brenulevi/airplane/Hardware/3D_Models/IND_PA4343_FOOTPRINT2_PUL.step

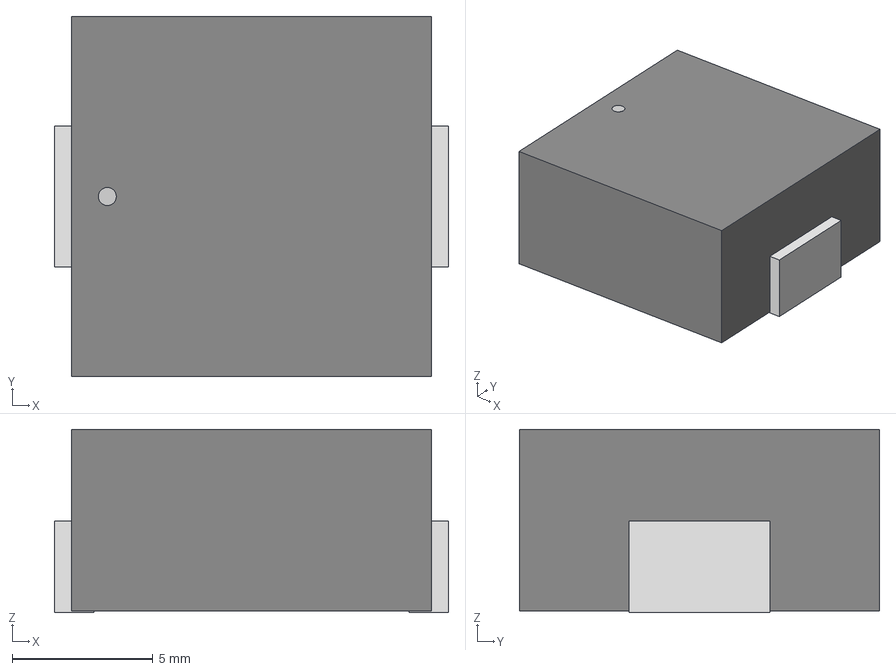
[picture p2: CAD file, 2026-01-26]
Hardware/3D_Models/IND_PA4343_FOOTPRINT2_PUL.step
14.0 x 12.8 x 6.50 mm
