brenulevi/airplane/Hardware/3D_Models/W25N01GVZEIG.STEP

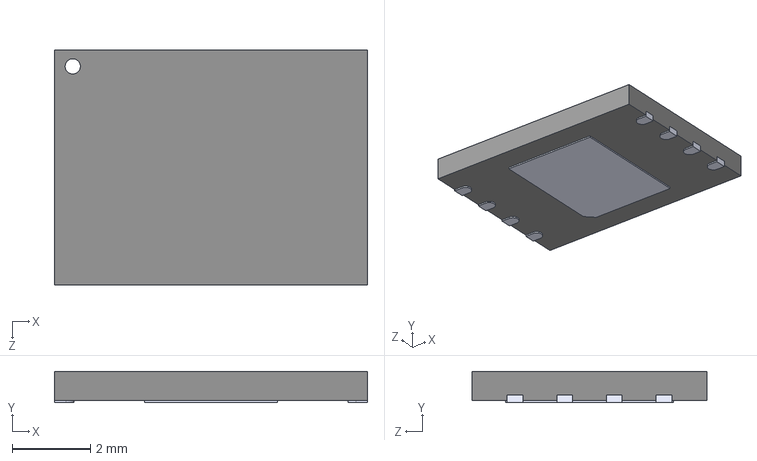
[picture p4: CAD file, 2026-01-26]
Hardware/3D_Models/W25N01GVZEIG.STEP
8.00 x 0.8 x 6.00 mm
