brenulevi/airplane/3D_Models/10LGA_2X2X0p75_BOS.step

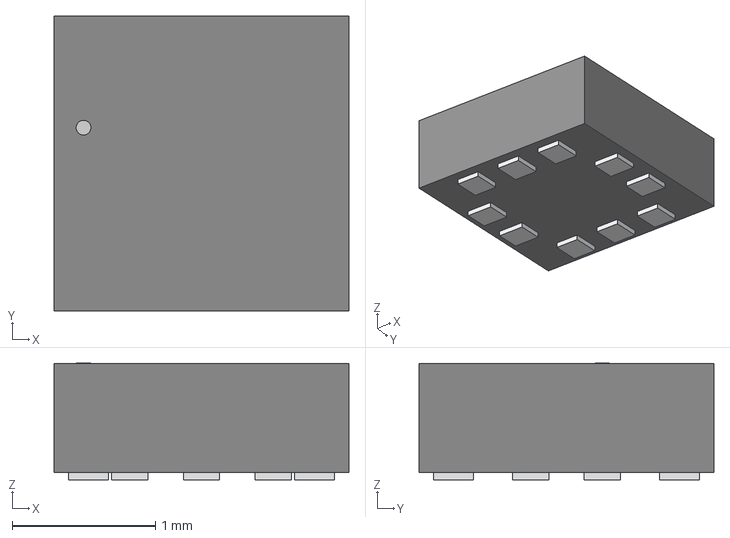
[picture p5: CAD file, 2026-01-13]
3D_Models/10LGA_2X2X0p75_BOS.step
2.06 x 2.06 x 0.815 mm
