brenulevi/airplane/3D_Models/BMI088.step

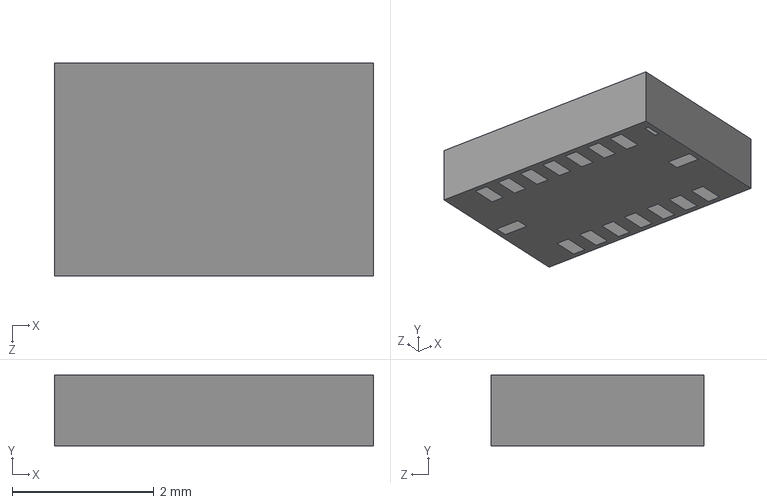
[picture p6: CAD file, 2026-01-13]
3D_Models/BMI088.step
4.50 x 1.00 x 3.00 mm
