brenulevi/airplane/Hardware/3D_Models/DM3AT-SF-PEJM5.step

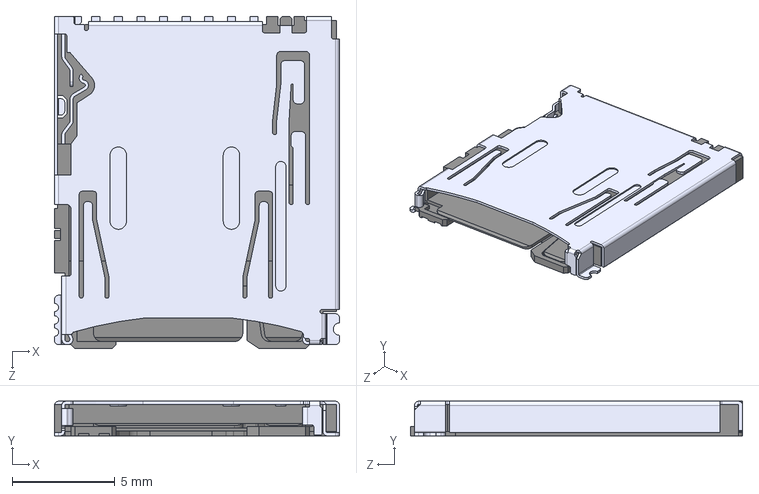
[picture p7: CAD file, 2026-01-26]
Hardware/3D_Models/DM3AT-SF-PEJM5.step
13.8 x 1.68 x 16.2 mm
