brenulevi/airplane/3D_Models/SON_DFN6_3X3_STM.step

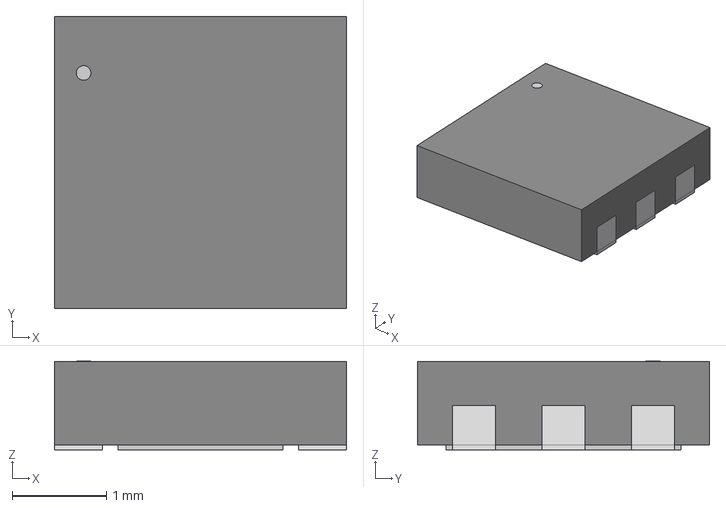
[picture p8: CAD file, 2026-01-13]
3D_Models/SON_DFN6_3X3_STM.step
3.10 x 3.10 x 0.942 mm
