brenulevi/airplane/Hardware/3D_Models/U.FL-R-SMT-1.stp

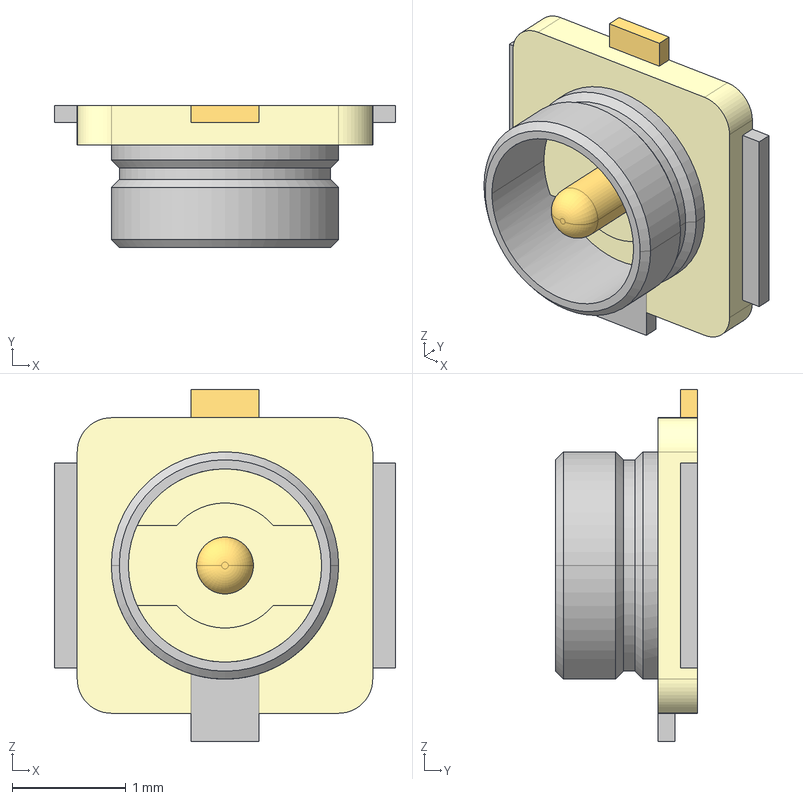
[picture p9: CAD file, 2026-01-23]
Hardware/3D_Models/U.FL-R-SMT-1.stp
3.00 x 1.25 x 3.10 mm
