brenulevi/airplane/3D_Models/IST8310.step

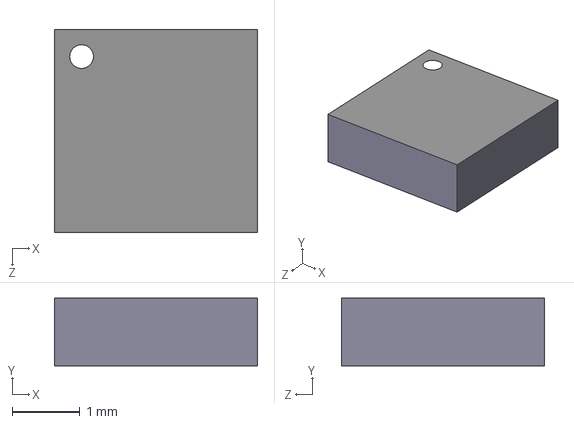
[picture p10: CAD file, 2026-01-13]
3D_Models/IST8310.step
3.00 x 1.00 x 3.00 mm
