brenulevi/airplane/Hardware/3D_Models/skrpace010.stp

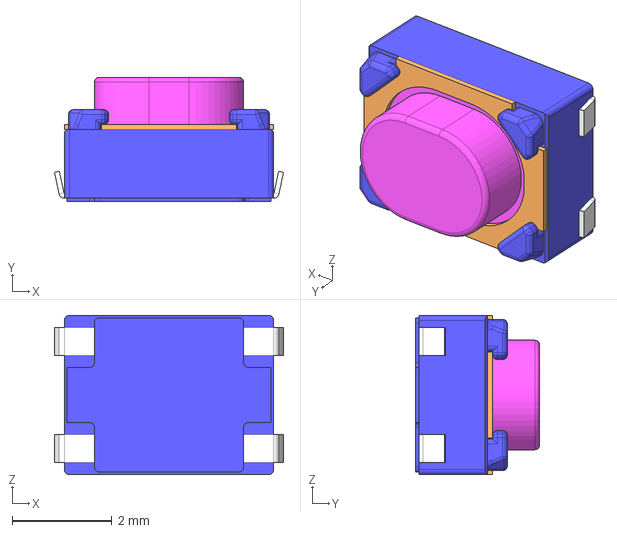
[picture p11: CAD file, 2026-01-23]
Hardware/3D_Models/skrpace010.stp
4.60 x 2.50 x 3.20 mm
