brenulevi/airplane/Hardware/3D_Models/B10B-PHDSS.STEP

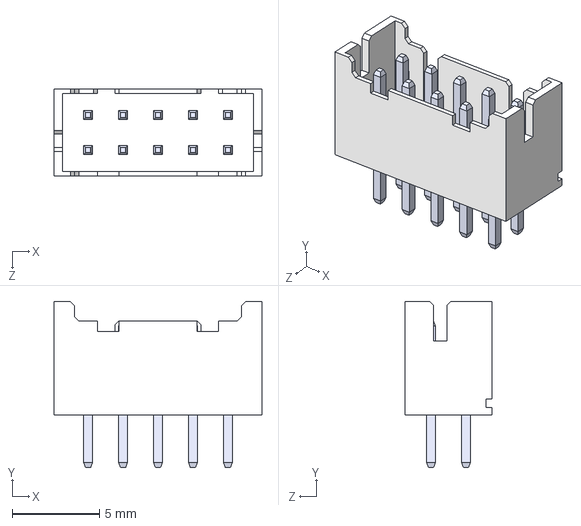
[picture p13: CAD file, 2026-01-23]
Hardware/3D_Models/B10B-PHDSS.STEP
11.9 x 9.50 x 5.00 mm
BxB-PHDSS_10
pin^BxB-PHDSS ass x 10
