brenulevi/airplane/3D_Models/SOT-23-5_2P9X1P6_MCH.step

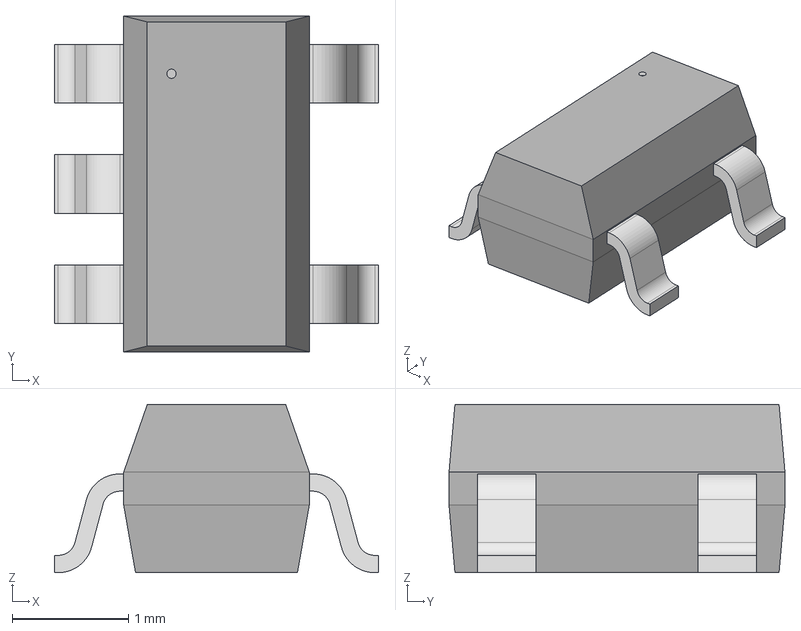
[picture p14: CAD file, 2026-01-13]
3D_Models/SOT-23-5_2P9X1P6_MCH.step
2.79 x 2.90 x 1.45 mm
