brenulevi/airplane/3D_Models/MIC26903YJL-TR.step

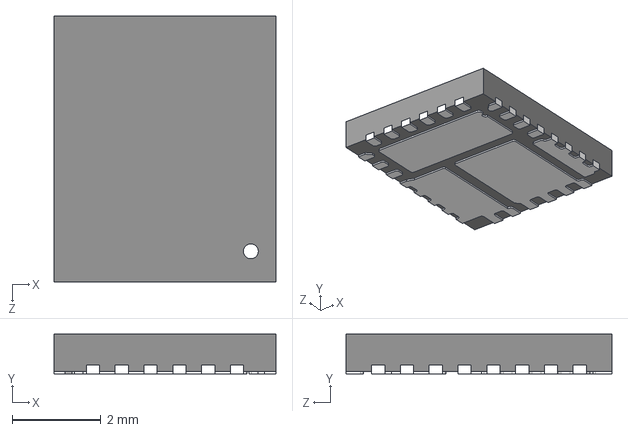
[picture p15: CAD file, 2026-01-13]
3D_Models/MIC26903YJL-TR.step
5.00 x 0.9 x 6.00 mm
