brenulevi/airplane/(list of files, cad)

Other CAD files:
Hardware/3D_Models/PTS815SJM250SMTRLFS.stp
Hardware/3D_Models/W25N01GVZEIG TR.STEP
