brenulevi/airplane/Hardware/aircraft.kicad_pcb

## KiCad design Hardware/aircraft.kicad_pcb (2026-01-28)

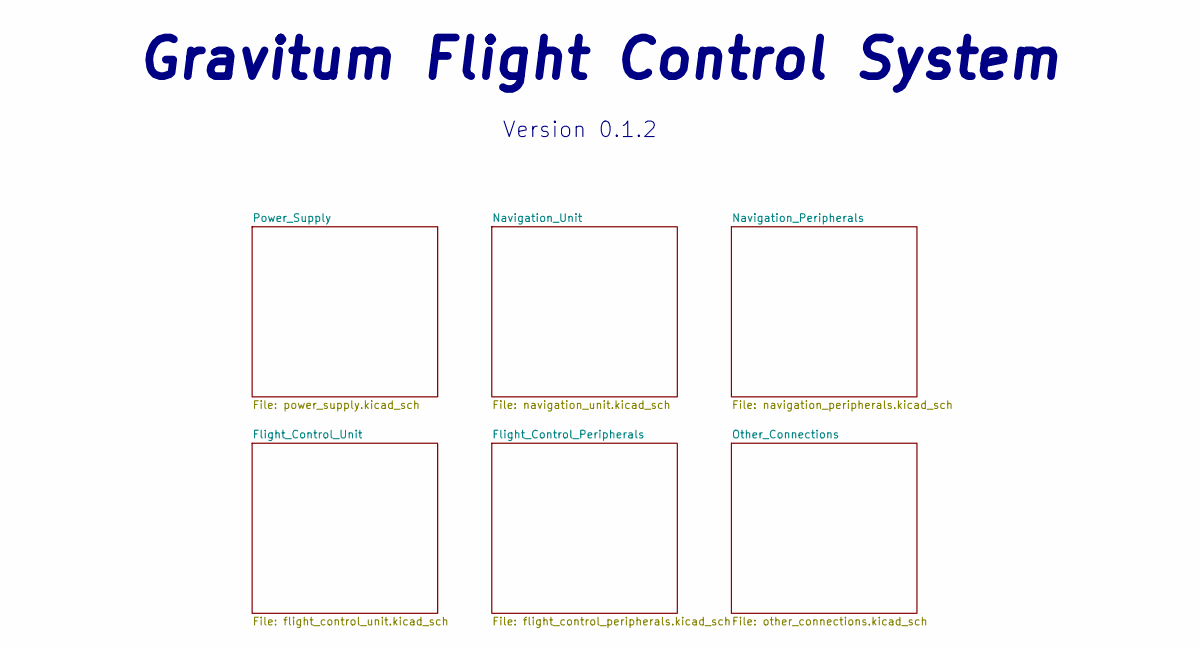
[picture p23: schematic aircraft.kicad_sch, Gravitum Flight Control System]

Notes on the sheet:
Gravitum Flight Control System
Version 0.1.2

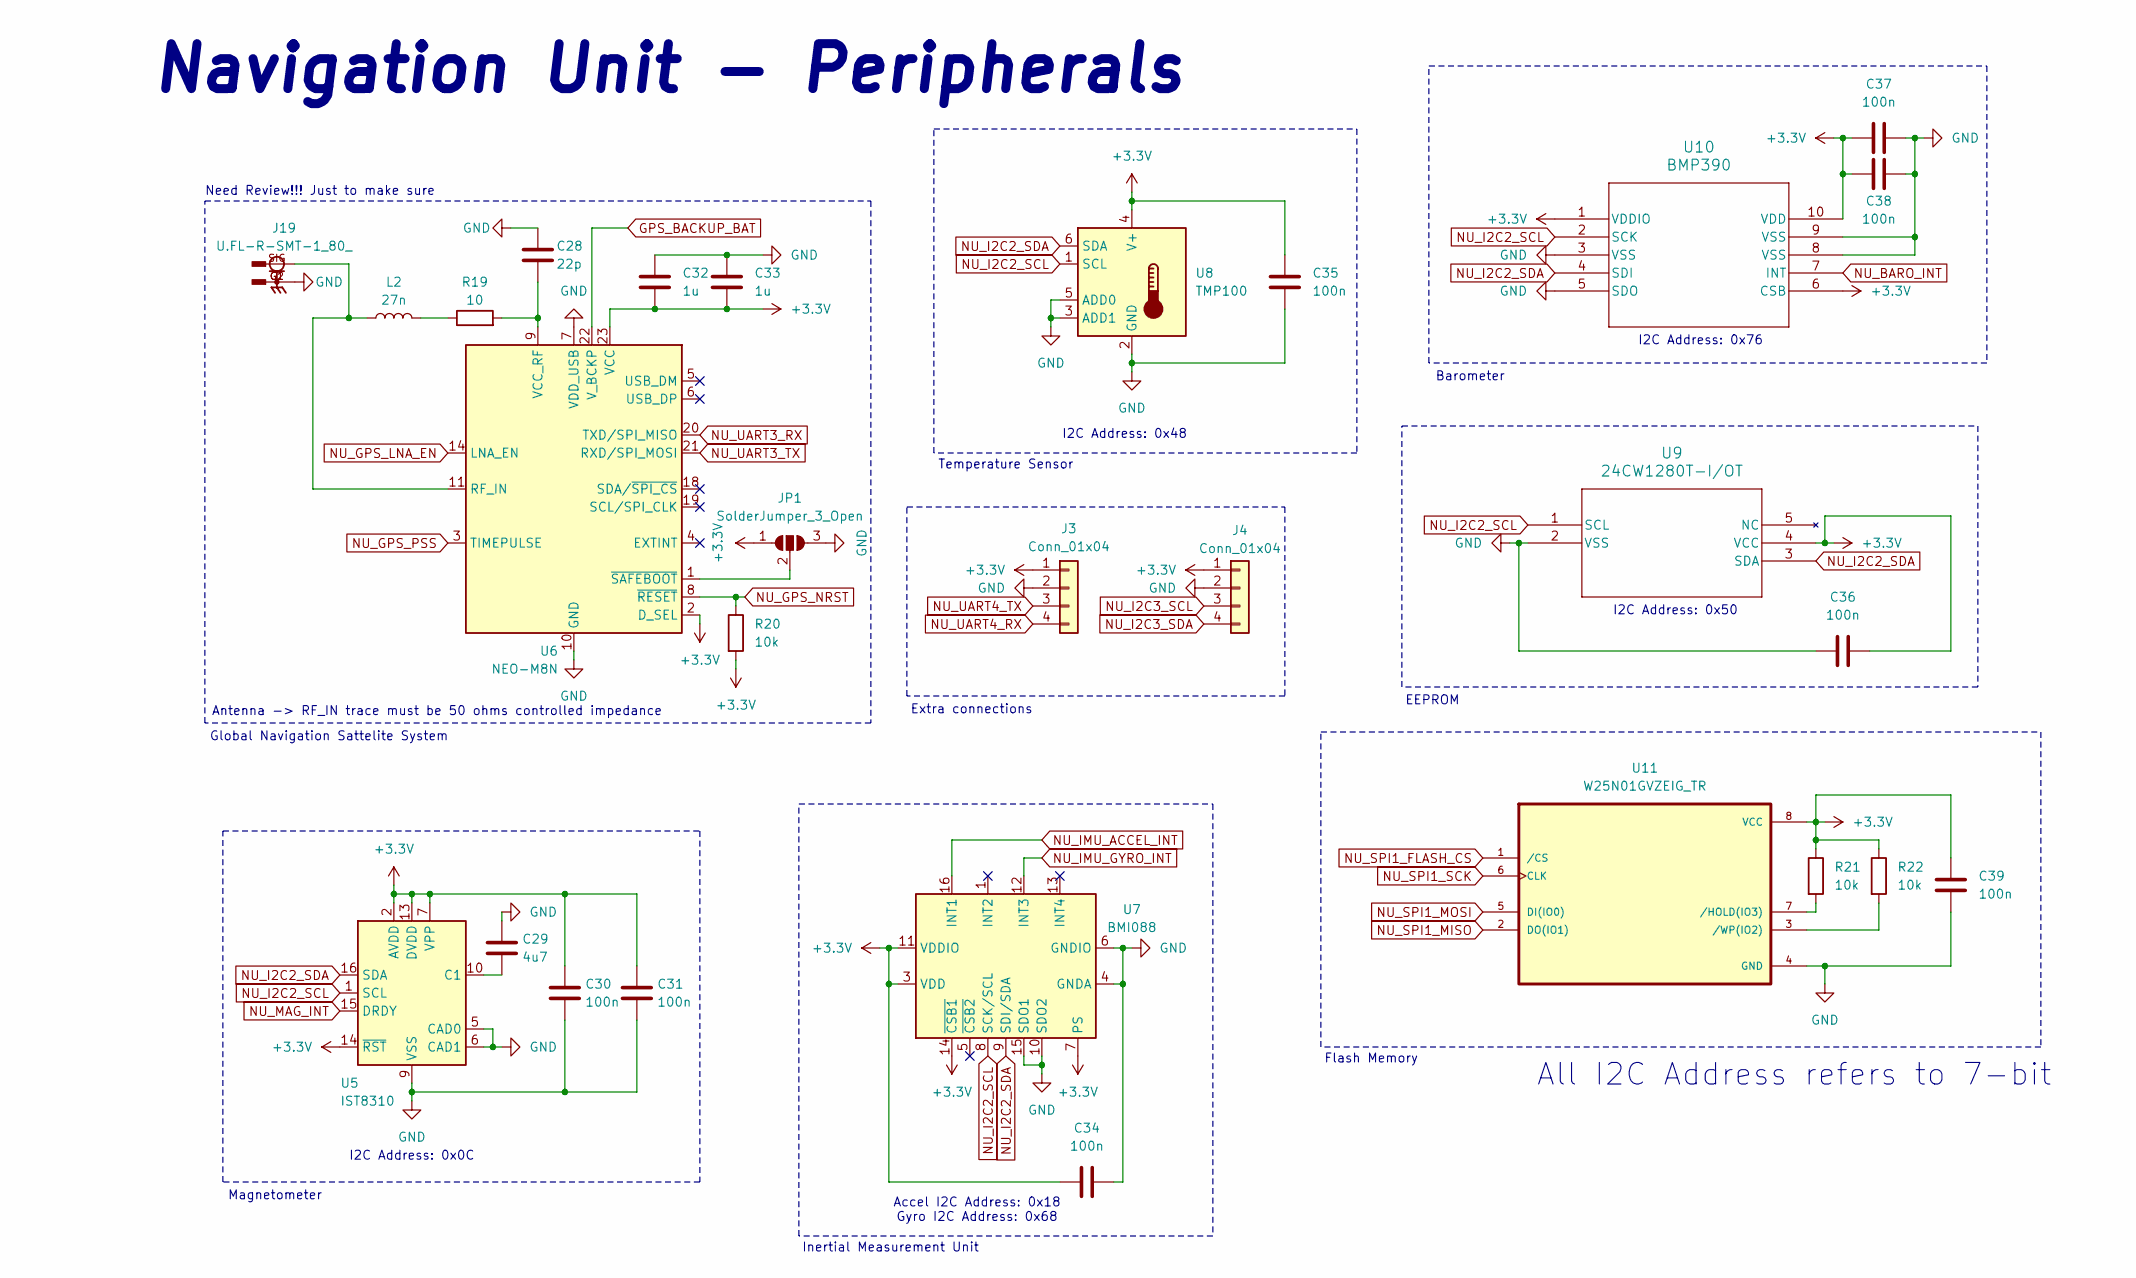
[picture p24: schematic navigation_peripherals.kicad_sch, Navigation Unit - Peripherals]

Parts:
C28: 22p; C_0603_1608Metric; MPN C0603C220J8GACTU
C29: 4u7; C_0805_2012Metric_Pad1.18x1.45mm_HandSolder; MPN CL21B475KPFNNNE
C30, C31, C34, C35, C36, C37, C38, C39: 100n; C_0603_1608Metric; MPN C0603C104K8RACTU
C32, C33: 1u; C_0603_1608Metric_Pad1.08x0.95mm_HandSolder; MPN CL10B105KP8NNNC
J3, J4: Conn_01x04; JST_PH_S4B-PH-K_1x04_P2.00mm_Horizontal; MPN S4B-PH-K-S
J19: U.FL-R-SMT-1_80_; HIROSE_U.FL-R-SMT-1_80_; PARTREV Jul.1.2022
JP1: SolderJumper_3_Open; SolderJumper-3_P1.3mm_Open_RoundedPad1.0x1.5mm_NumberLabels
L2: 27n; L_0603_1608Metric_Pad1.05x0.95mm_HandSolder; MPN B82496C3270J000
R19: 10; R_0603_1608Metric_Pad0.98x0.95mm_HandSolder; MPN RMCF0603FT10R0
R20, R21, R22: 10k; R_0603_1608Metric_Pad0.98x0.95mm_HandSolder; MPN RC0603FR-0710KL
U5: IST8310; LGA-16_3x3mm_P0.5mm; MPN IST8310
U6: NEO-M8N; XCVR_NEO-M8N-0; MPN NEO-M8N-0
U7: BMI088; Bosch_LGA-16_4.5x3mm_P0.5mm_LayoutBorder7x1y_ClockwisePinNu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; MPN BMI088
U8: TMP100; SOT-23-6; MPN TMP100NA-3K
U9: 24CW1280T-I/OT; SOT-23-5_2P9X1P6_MCH; MPN 24CW1280T-I/OT
U10: BMP390; 10LGA_2X2X0p75_BOS; MPN BMP390
U11: W25N01GVZEIG_TR; SON127P800X600X80-9N; MPN W25N01GVZEIG-TR

Connections:
+3.3V: C30.1, C31.1, C32.2, C33.2, C34.1, C35.2, C36.1, C37.2, C38.2, C39.1, J3.1, J4.1, JP1.1 (A), R20.2, R21.1, R22.1, U5.2 (AVDD), U5.7 (VPP), U5.13 (DVDD), U5.14 (~RST), U6.2 (D_SEL), U6.23 (VCC), U7.3 (VDD), U7.7 (PS), U7.11 (VDDIO), U7.14 (~CSB1), U8.4 (V+), U9.4 (VCC), U10.1 (VDDIO), U10.6 (CSB), U10.10 (VDD), U11.8 (VCC); also elsewhere on the board
GND: C28.1, C29.1, C30.2, C31.2, C32.1, C33.1, C34.2, C35.1, C36.2, C37.1, C38.1, C39.2, J3.2, J4.2, J19.G1, J19.G2, JP1.3 (B), U5.5 (CAD0), U5.6 (CAD1), U5.9 (VSS), U5.11 (VSS), U6.7 (VDD_USB), U6.10 (GND), U6.12 (GND), U6.13 (GND), U6.24 (GND), U7.2 (GNDA), U7.4 (GNDA), U7.6 (GNDIO), U7.10 (SDO2), U7.15 (SDO1), U8.2 (GND), U8.3 (ADD1), U8.5 (ADD0), U9.2 (VSS), U10.3 (VSS), U10.5 (SDO), U10.8 (VSS), U10.9 (VSS), U11.4 (GND); also elsewhere on the board
GPS_BACKUP_BAT: U6.22 (V_BCKP); also elsewhere on the board
NU_BARO_INT: U10.7 (INT); also elsewhere on the board
NU_GPS_LNA_EN: U6.14 (LNA_EN); also elsewhere on the board
NU_GPS_NRST: R20.1, U6.8 (~RESET); also elsewhere on the board
NU_GPS_PSS: U6.3 (TIMEPULSE); also elsewhere on the board
NU_I2C2_SCL: U5.1 (SCL), U7.8 (SCK/SCL), U8.1 (SCL), U9.1 (SCL), U10.2 (SCK); also elsewhere on the board
NU_I2C2_SDA: U5.16 (SDA), U7.9 (SDI/SDA), U8.6 (SDA), U9.3 (SDA), U10.4 (SDI); also elsewhere on the board
NU_I2C3_SCL: J4.3; also elsewhere on the board
NU_I2C3_SDA: J4.4; also elsewhere on the board
NU_IMU_ACCEL_INT: U7.16 (INT1); also elsewhere on the board
NU_IMU_GYRO_INT: U7.12 (INT3); also elsewhere on the board
NU_MAG_INT: U5.15 (DRDY); also elsewhere on the board
NU_SPI1_FLASH_CS: U11.1 (/CS); also elsewhere on the board
NU_SPI1_MISO: U11.2 (DO(IO1)); also elsewhere on the board
NU_SPI1_MOSI: U11.5 (DI(IO0)); also elsewhere on the board
NU_SPI1_SCK: U11.6 (CLK); also elsewhere on the board
NU_UART3_RX: U6.20 (TXD/SPI_MISO); also elsewhere on the board
NU_UART3_TX: U6.21 (RXD/SPI_MOSI); also elsewhere on the board
NU_UART4_RX: J3.4; also elsewhere on the board
NU_UART4_TX: J3.3; also elsewhere on the board
unnamed: JP1.2 (C), U6.1 (~SAFEBOOT)
unnamed: L2.2, R19.1
unnamed: C29.2, U5.10 (C1)
unnamed: J19.SIG, L2.1, U6.11 (RF_IN)
unnamed: C28.2, R19.2, U6.9 (VCC_RF)
unnamed: R21.2, U11.7 (/HOLD(IO3))
unnamed: R22.2, U11.3 (/WP(IO2))

Notes on the sheet:
Magnetometer
Navigation Unit - Peripherals
I2C Address: 0x48
Flash Memory
I2C Address: 0x76
Barometer
Temperature Sensor
Accel I2C Address: 0x18 Gyro I2C Address: 0x68
EEPROM
Need Review!!! Just to make sure
Global Navigation Sattelite System
Inertial Measurement Unit
All I2C Address refers to 7-bit
Antenna -> RF_IN trace must be 50 ohms controlled impedance
I2C Address: 0x0C
I2C Address: 0x50
Extra connections

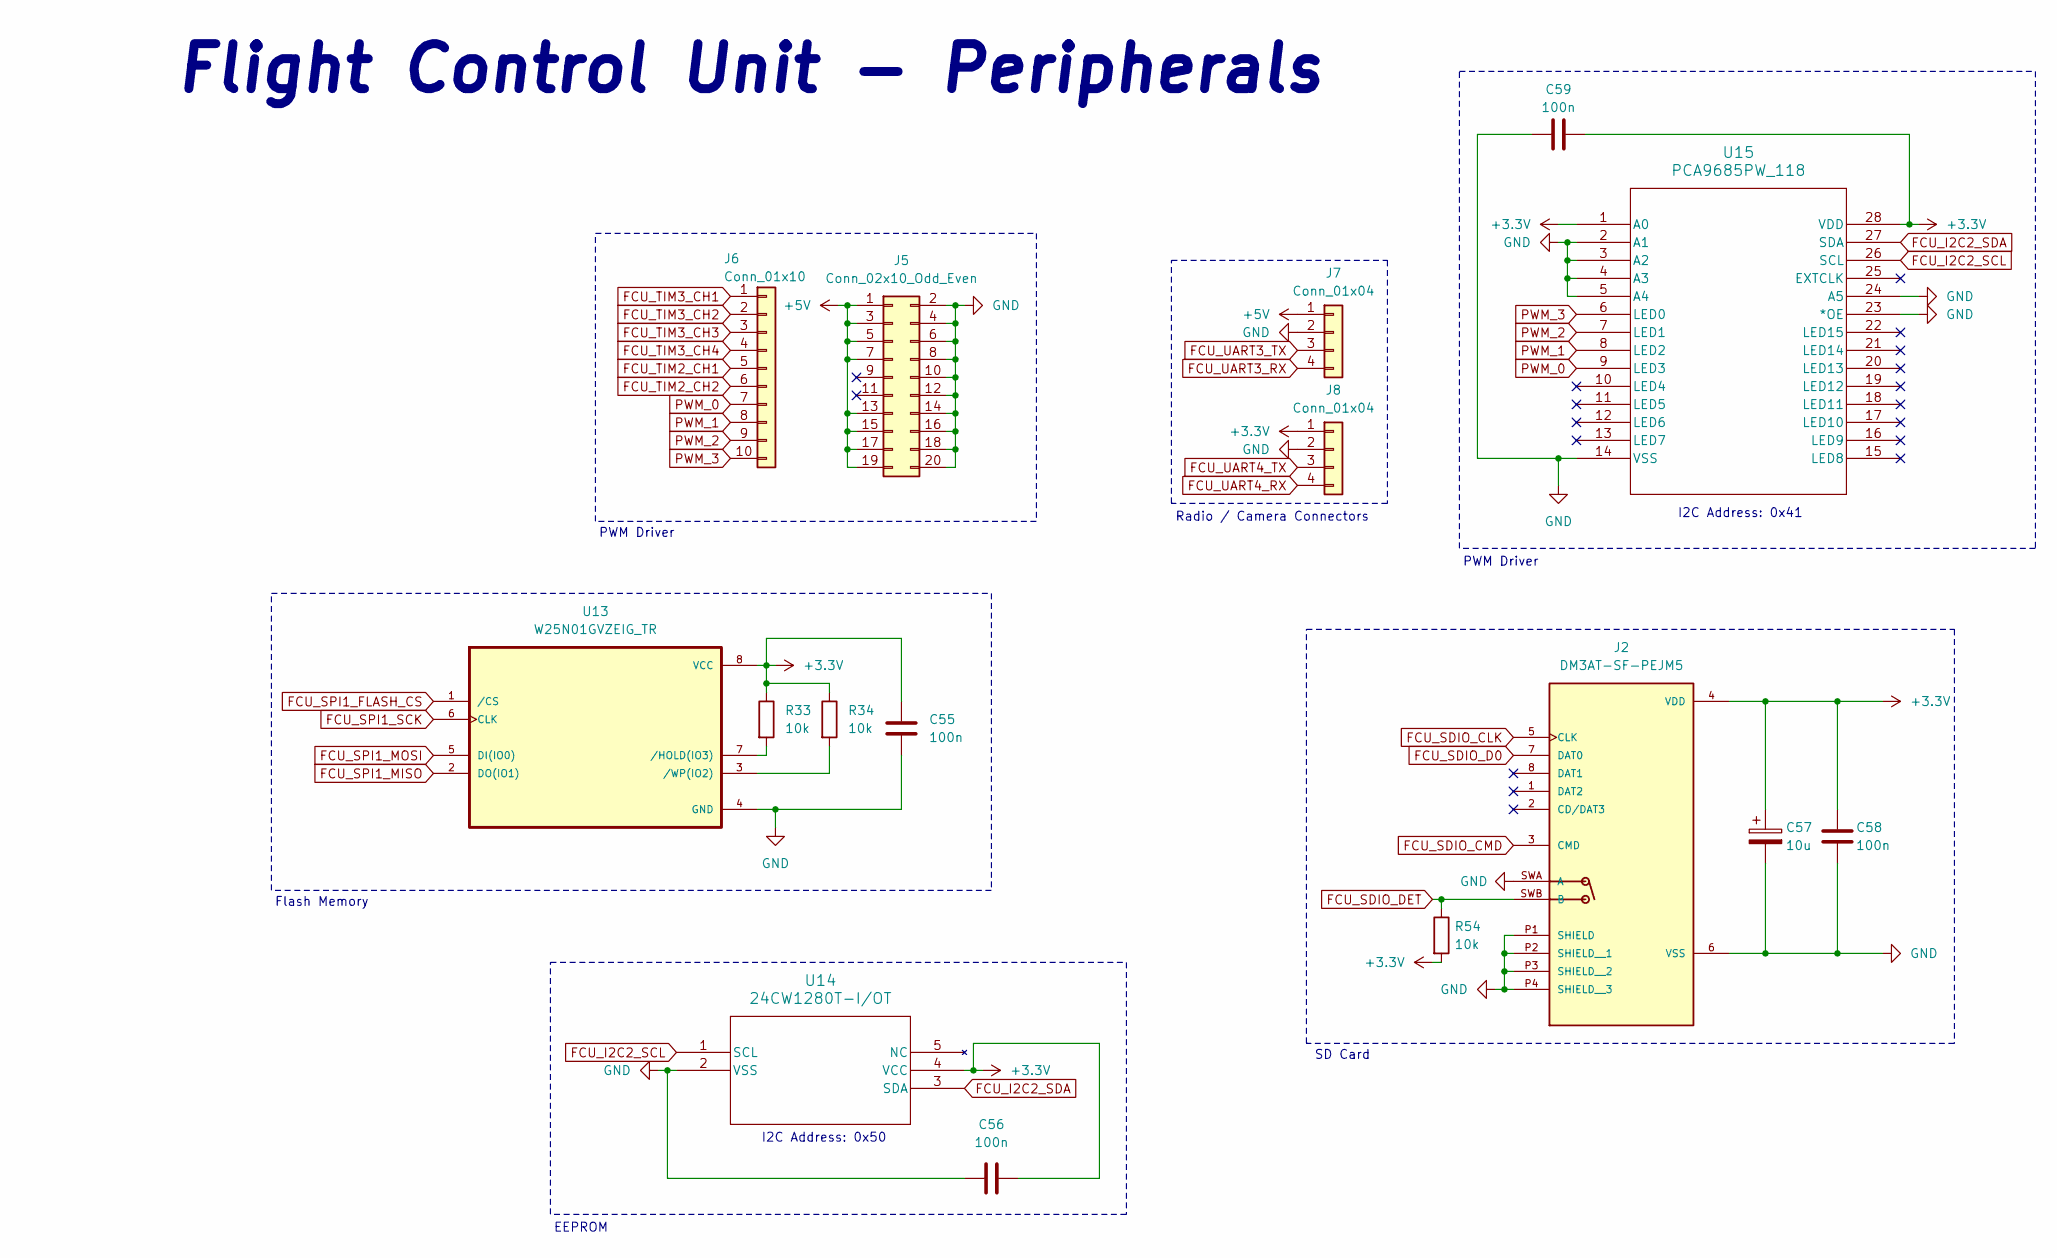
[picture p25: schematic flight_control_peripherals.kicad_sch, Flight Control Unit - Peripherals]

Parts:
C55, C56, C58, C59: 100n; C_0402_1005Metric; MPN C0603C104K8RACTU
C57: 10u; C_0603_1608Metric; MPN TAJA106K010TNJ
J2: DM3AT-SF-PEJM5; HRS_DM3AT-SF-PEJM5; PARTREV 20200913
J5: Conn_02x10_Odd_Even; PinHeader_2x10_P2.54mm_Vertical
J6: Conn_01x10; PinHeader_1x10_P2.54mm_Vertical
J7, J8: Conn_01x04; JST_PH_S4B-PH-K_1x04_P2.00mm_Horizontal; MPN S4B-PH-K-S
R33, R34, R54: 10k; R_0402_1005Metric; MPN RC0603FR-0710KL
U13: W25N01GVZEIG_TR; SON127P800X600X80-9N; MPN W25N01GVZEIG-TR
U14: 24CW1280T-I/OT; SOT-23-5_2P9X1P6_MCH; MPN 24CW1280T-I/OT
U15: PCA9685PW_118; TSSOP28_SOT361-1_NXP; MPN PCA9685PW,118

Connections:
+3.3V: C55.1, C56.1, C57.1, C58.1, C59.1, J2.4 (VDD), J8.1, R33.1, R34.1, R54.2, U13.8 (VCC), U14.4 (VCC), U15.1 (A0), U15.28 (VDD); also elsewhere on the board
+5V: J5.1, J5.3, J5.5, J5.7, J5.13, J5.15, J5.17, J5.19, J7.1; also elsewhere on the board
FCU_I2C2_SCL: U14.1 (SCL), U15.26 (SCL); also elsewhere on the board
FCU_I2C2_SDA: U14.3 (SDA), U15.27 (SDA); also elsewhere on the board
FCU_SDIO_CLK: J2.5 (CLK); also elsewhere on the board
FCU_SDIO_CMD: J2.3 (CMD); also elsewhere on the board
FCU_SDIO_D0: J2.7 (DAT0); also elsewhere on the board
FCU_SDIO_DET: J2.SWB (B), R54.1; also elsewhere on the board
FCU_SPI1_FLASH_CS: U13.1 (/CS); also elsewhere on the board
FCU_SPI1_MISO: U13.2 (DO(IO1)); also elsewhere on the board
FCU_SPI1_MOSI: U13.5 (DI(IO0)); also elsewhere on the board
FCU_SPI1_SCK: U13.6 (CLK); also elsewhere on the board
FCU_TIM2_CH1: J6.5; also elsewhere on the board
FCU_TIM2_CH2: J6.6; also elsewhere on the board
FCU_TIM3_CH1: J6.1; also elsewhere on the board
FCU_TIM3_CH2: J6.2; also elsewhere on the board
FCU_TIM3_CH3: J6.3; also elsewhere on the board
FCU_TIM3_CH4: J6.4; also elsewhere on the board
FCU_UART3_RX: J7.4; also elsewhere on the board
FCU_UART3_TX: J7.3; also elsewhere on the board
FCU_UART4_RX: J8.4; also elsewhere on the board
FCU_UART4_TX: J8.3; also elsewhere on the board
GND: C55.2, C56.2, C57.2, C58.2, C59.2, J2.6 (VSS), J2.P1 (SHIELD), J2.P2 (SHIELD__1), J2.P3 (SHIELD__2), J2.P4 (SHIELD__3), J2.SWA (A), J5.2, J5.4, J5.6, J5.8, J5.10, J5.12, J5.14, J5.16, J5.18, J5.20, J7.2, J8.2, U13.4 (GND), U14.2 (VSS), U15.2 (A1), U15.3 (A2), U15.4 (A3), U15.5 (A4), U15.14 (VSS), U15.23 (*OE), U15.24 (A5); also elsewhere on the board
unnamed: R33.2, U13.7 (/HOLD(IO3))
unnamed: R34.2, U13.3 (/WP(IO2))
PWM_0: J6.7, U15.9 (LED3)
PWM_1: J6.8, U15.8 (LED2)
PWM_2: J6.9, U15.7 (LED1)
PWM_3: J6.10, U15.6 (LED0)

Notes on the sheet:
I2C Address: 0x50
I2C Address: 0x41
Radio / Camera Connectors
SD Card
PWM Driver
Flash Memory
Flight Control Unit - Peripherals
EEPROM

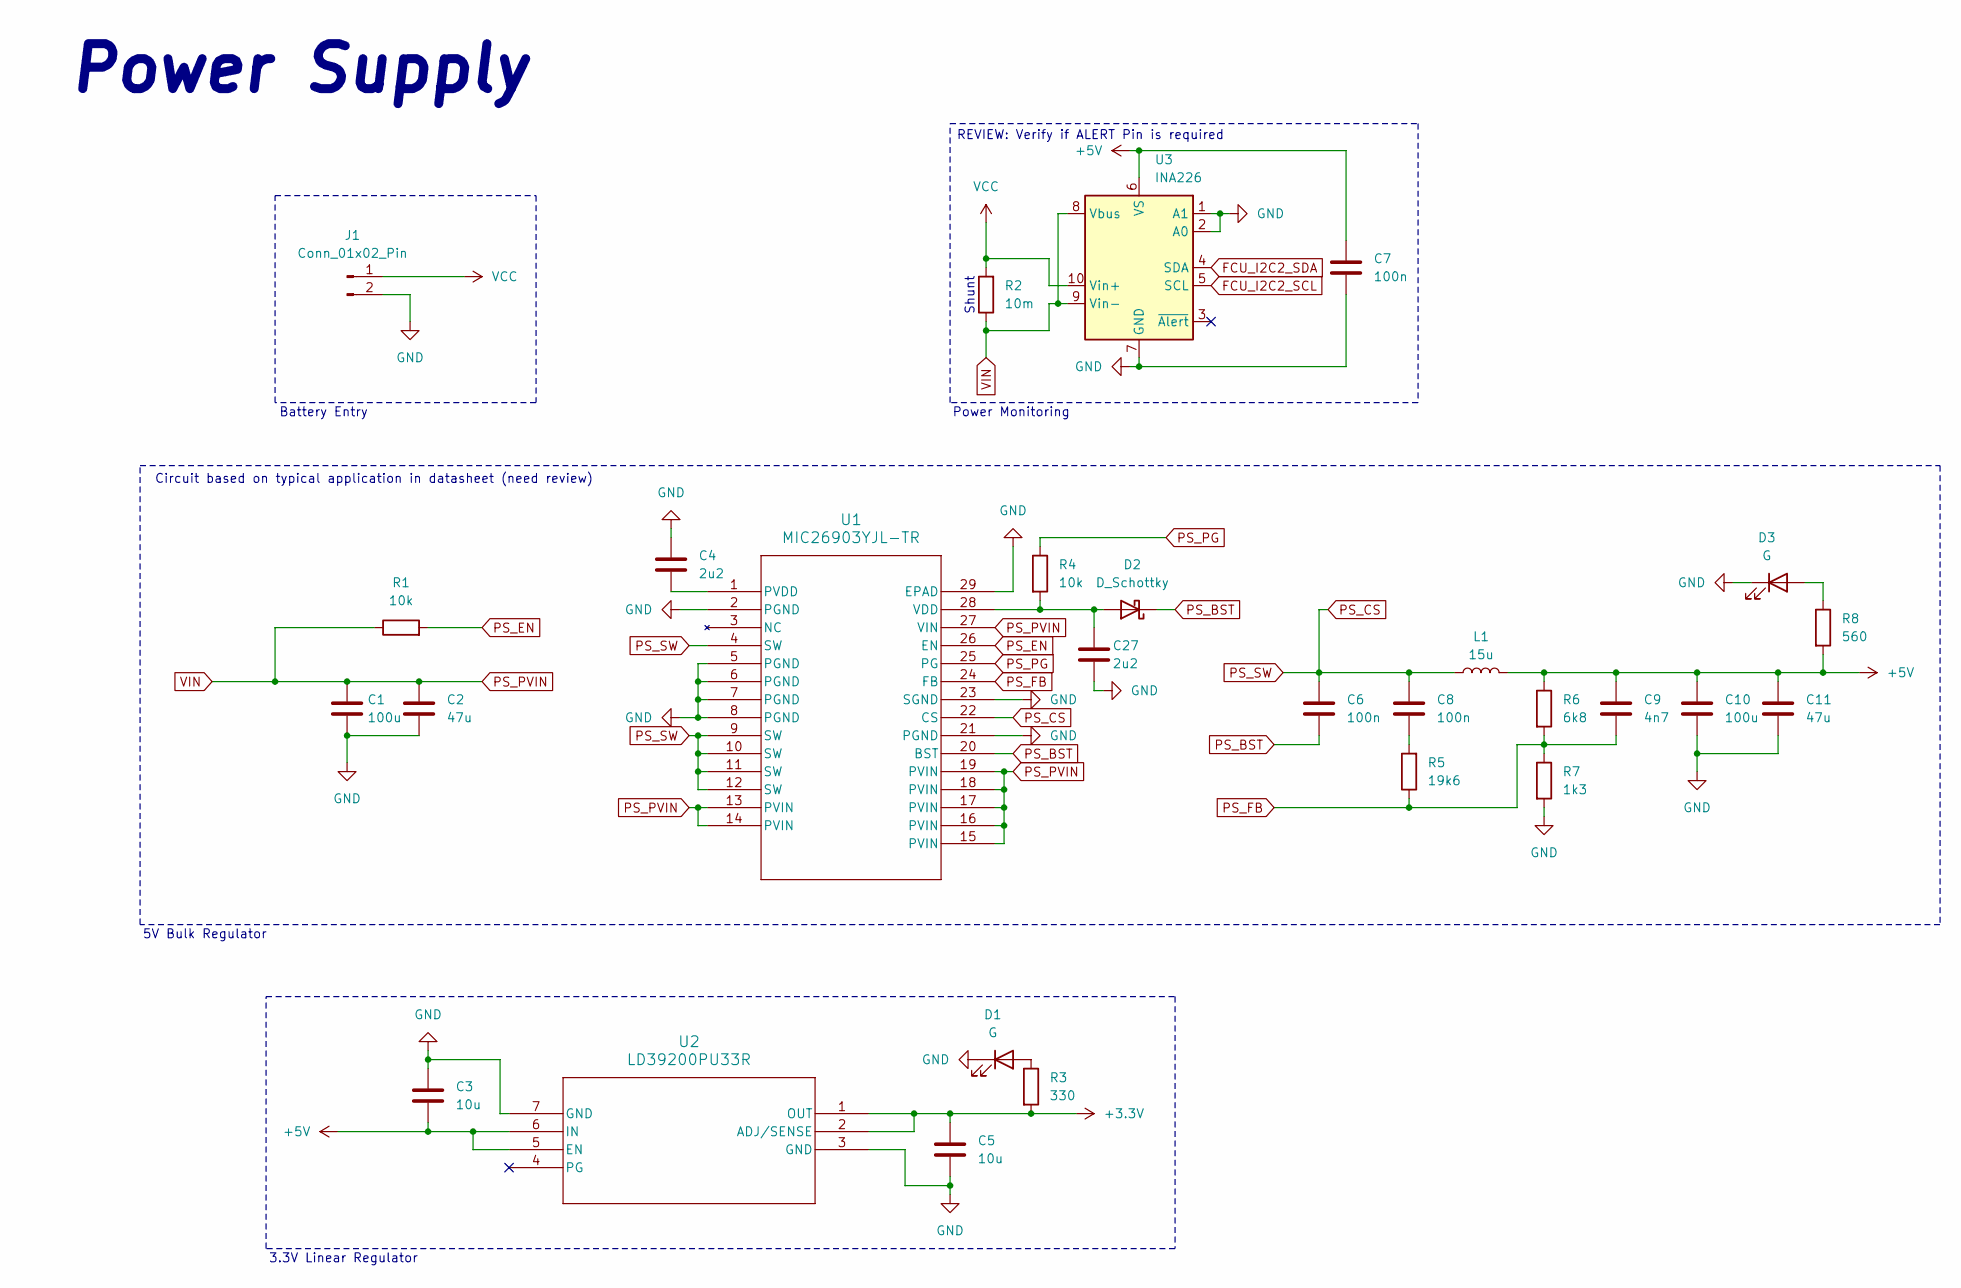
[picture p26: schematic power_supply.kicad_sch, Power Supply]

Parts:
C1, C10: 100u; C_Elec_6.3x7.7; MPN A768EB107M1ELAS036
C2, C11: 47u; C_1206_3216Metric_Pad1.33x1.80mm_HandSolder; MPN C3216X5R1E476M160AC
C3, C5: 10u; C_0805_2012Metric_Pad1.18x1.45mm_HandSolder; MPN CL21B106KPQNNNE
C4, C27: 2u2; C_0805_2012Metric_Pad1.18x1.45mm_HandSolder; MPN 08053C225KAT2A
C6, C7, C8: 100n; C_0603_1608Metric_Pad1.08x0.95mm_HandSolder; MPN C0603C104K3RACTU
C9: 4n7; C_0603_1608Metric_Pad1.08x0.95mm_HandSolder; MPN C0603C472F3GACTU
D1, D3: G; LED_0603_1608Metric_Pad1.05x0.95mm_HandSolder; MPN LTST-S270KGKT
D2: D_Schottky; D_SOD-323_HandSoldering; MPN SD103AWS
J1: Conn_01x02_Pin; AMASS_XT60-M_1x02_P7.20mm_Vertical; MPN 11864
L1: 15u; IND_PA4343_FOOTPRINT2_PUL; MPN PA4343-103ANLT
R1, R4: 10k; R_0603_1608Metric_Pad0.98x0.95mm_HandSolder; MPN RC0603FR-0710KL
R2: 10m; R_2512_6332Metric_Pad1.40x3.35mm_HandSolder; MPN CRF2512-FZ-R010ELF
R3: 330; R_0603_1608Metric_Pad0.98x0.95mm_HandSolder; MPN RC0603JR-07330RL
R5: 19k6; R_0603_1608Metric_Pad0.98x0.95mm_HandSolder; MPN CRCW060319K6FKEAC
R6: 6k8; R_0603_1608Metric_Pad0.98x0.95mm_HandSolder; MPN RC0603JR-076K8L
R7: 1k3; R_0603_1608Metric_Pad0.98x0.95mm_HandSolder; MPN RC0603JR-071K3L
R8: 560; R_0603_1608Metric_Pad0.98x0.95mm_HandSolder; MPN RMCF0603FT560R
U1: MIC26903YJL-TR; MLF28_5X6_MCH; MPN MIC26903YJL-TR
U2: LD39200PU33R; SON_DFN6_3X3_STM; MPN LD39200PU33R
U3: INA226; DGS10; MPN INA226AIDGST

Connections:
+3.3V: C5.1, R3.2, U2.1 (OUT), U2.2 (ADJ/SENSE); also elsewhere on the board
+5V: C3.2, C7.1, C9.1, C10.1, C11.1, L1.2, R6.1, R8.2, U2.5 (EN), U2.6 (IN), U3.6 (VS); also elsewhere on the board
FCU_I2C2_SCL: U3.5 (SCL); also elsewhere on the board
FCU_I2C2_SDA: U3.4 (SDA); also elsewhere on the board
GND: C1.2, C2.2, C3.1, C4.1, C5.2, C7.2, C10.2, C11.2, C27.2, D1.1 (K), D3.1 (K), J1.2, R7.2, U1.2 (PGND), U1.5 (PGND), U1.6 (PGND), U1.7 (PGND), U1.8 (PGND), U1.21 (PGND), U1.23 (SGND), U1.29 (EPAD), U2.3 (GND), U2.7 (GND), U3.1 (A1), U3.2 (A0), U3.7 (GND); also elsewhere on the board
unnamed: C8.2, R5.2
unnamed: D1.2 (A), R3.1
unnamed: C27.1, D2.2 (A), R4.2, U1.28 (VDD)
unnamed: D3.2 (A), R8.1
unnamed: C4.2, U1.1 (PVDD)
PS_BST: C6.2, D2.1 (K), U1.20 (BST)
PS_CS: C6.1, C8.1, L1.1, U1.4 (SW), U1.9 (SW), U1.10 (SW), U1.11 (SW), U1.12 (SW), U1.22 (CS)
PS_EN: R1.2, U1.26 (EN)
PS_FB: C9.2, R5.1, R6.2, R7.1, U1.24 (FB)
PS_PG: R4.1, U1.25 (PG)
PS_PVIN: C1.1, C2.1, R1.1, R2.1, U1.13 (PVIN), U1.14 (PVIN), U1.15 (PVIN), U1.16 (PVIN), U1.17 (PVIN), U1.18 (PVIN), U1.19 (PVIN), U1.27 (VIN), U3.8 (Vbus), U3.9 (Vin-); also elsewhere on the board
VIN+: J1.1, R2.2, U3.10 (Vin+); also elsewhere on the board

Notes on the sheet:
Power Supply
Shunt
5V Bulk Regulator
REVIEW: Verify if ALERT Pin is required
Circuit based on typical application in datasheet (need review)
Battery Entry
3.3V Linear Regulator
Power Monitoring

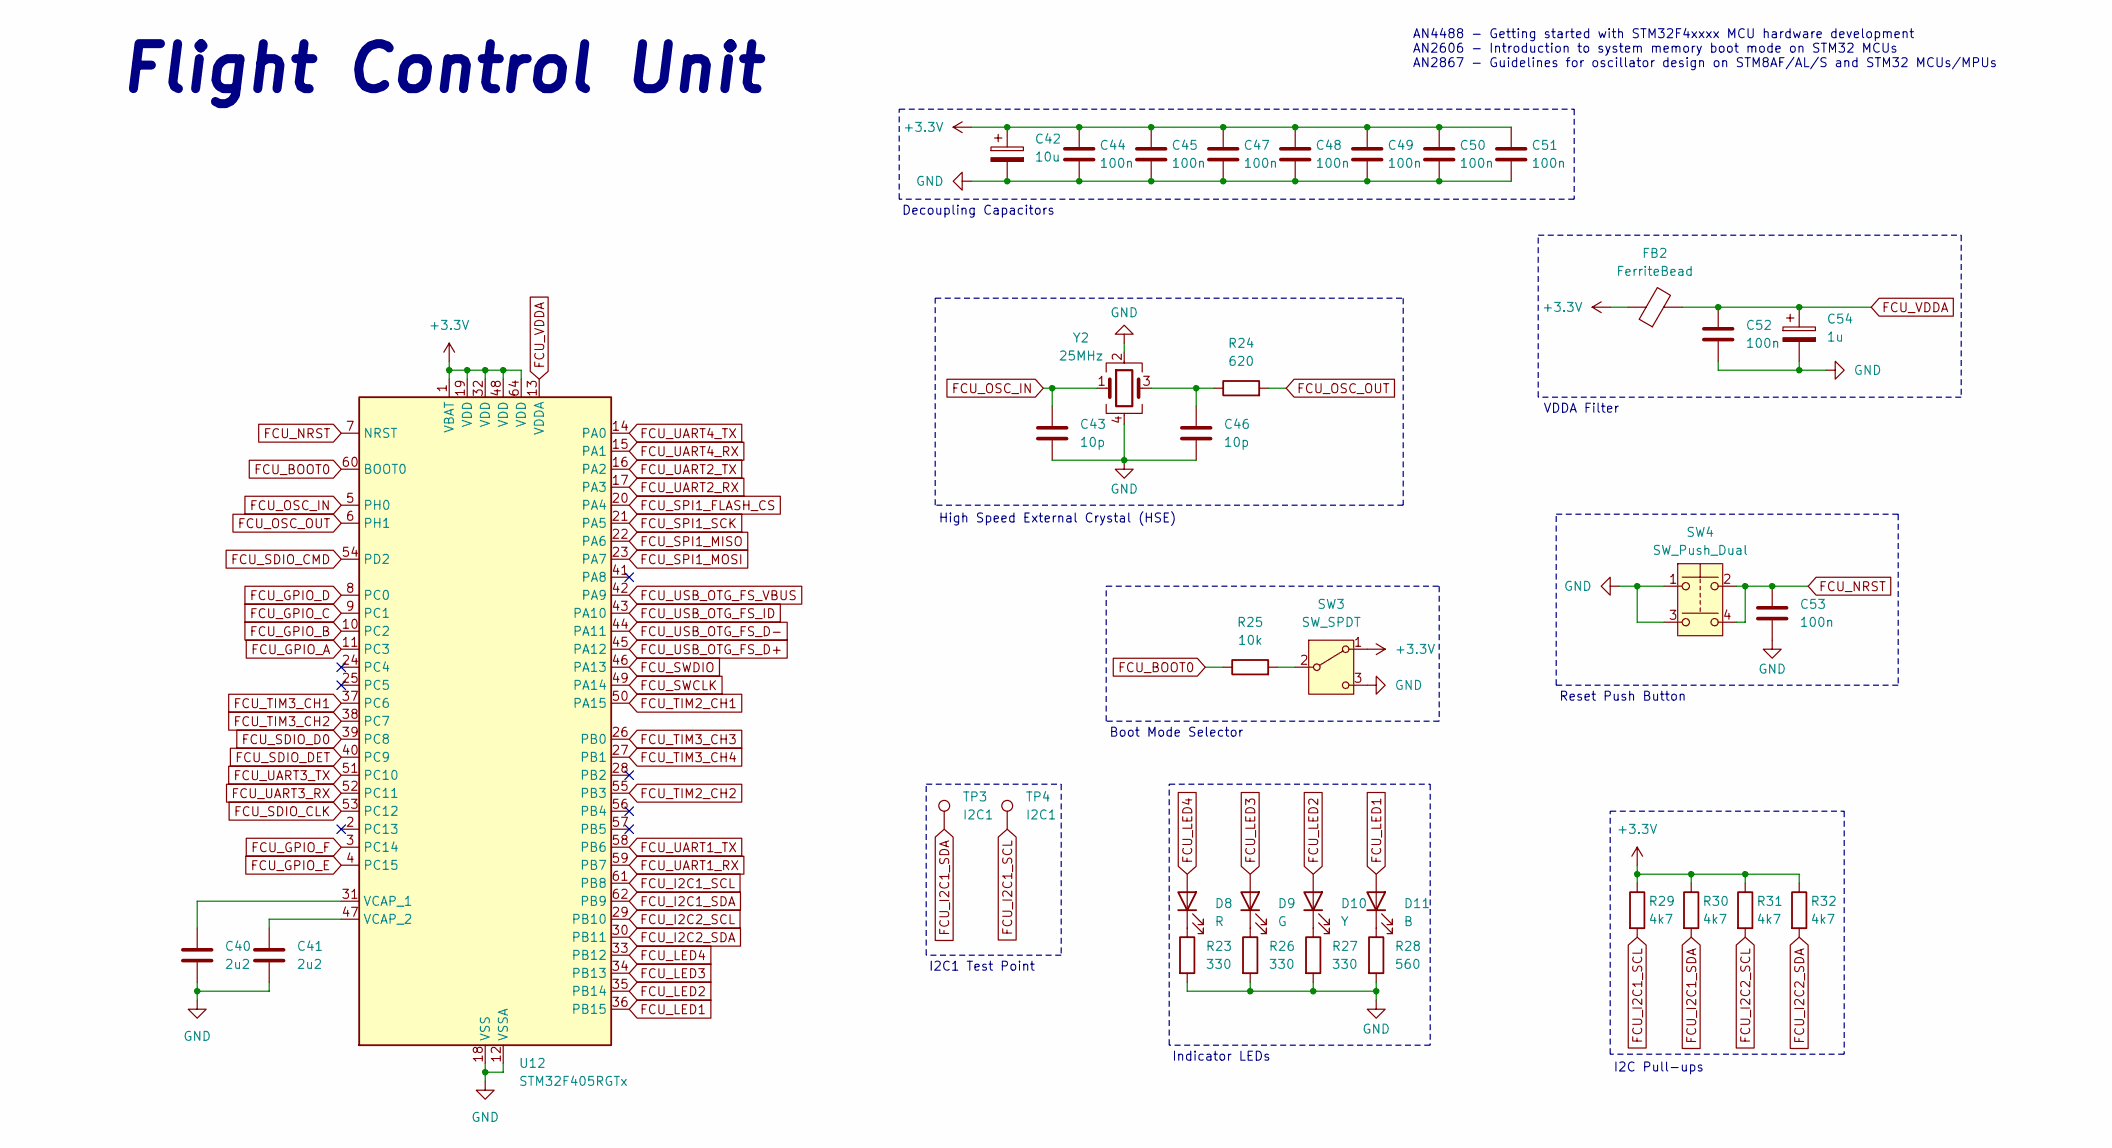
[picture p27: schematic flight_control_unit.kicad_sch, Flight Control Unit]

Parts:
C40, C41: 2u2; C_0402_1005Metric; MPN CL10B225KP8NNNC
C42: 10u; C_0603_1608Metric; MPN TAJA106K010TNJ
C43, C46: 10p; C_0402_1005Metric; MPN 885012005007
C44, C45, C47, C48, C49, C50, C51, C52: 100n; C_0402_1005Metric; MPN CL05B104KP5NNNC
C53: 100n; C_0402_1005Metric; MPN C0603C104K8RACTU
C54: 1u; CP_EIA-1608-08_AVX-J; MPN T491A105K010AT
D8: R; LED_0402_1005Metric; MPN LTST-C171KRKT
D9: G; LED_0402_1005Metric; MPN LTST-C170GKT
D10: Y; LED_0402_1005Metric; MPN LTST-C171YKT
D11: B; LED_0402_1005Metric; MPN LTST-C171TBKT
FB2: FerriteBead; L_0402_1005Metric; MPN HZ0805E601R-10
R23, R26, R27: 330; R_0402_1005Metric; MPN RC0603JR-07330RL
R24: 620; R_0402_1005Metric; MPN RC0603FR-07620RL
R25: 10k; R_0402_1005Metric; MPN RC0603FR-0710KL
R28: 560; R_0402_1005Metric; MPN RMCF0603FT560R
R29, R30, R31, R32: 4k7; R_0402_1005Metric; MPN ERJ-3EKF4701V
SW3: SW_SPDT; SW_SPDT_PCM12; MPN PCM12SMTR
SW4: SW_Push_Dual; SW4_PTS815 SJM 250 SMTR LFS_CNK; MPN PTS815SJM250SMTRLFS
TP3, TP4: I2C1; TestPoint_Pad_D1.0mm
U12: STM32F405RGTx; LQFP-64_10x10mm_P0.5mm; MPN STM32F405RGT6
Y2: 25MHz; Crystal_SMD_Abracon_ABM8G-4Pin_3.2x2.5mm; MPN ABM8G-25.000MHZ-B4Y-T3

Connections:
+3.3V: C42.1, C44.1, C45.1, C47.1, C48.1, C49.1, C50.1, C51.1, FB2.1, R29.1, R30.1, R31.1, R32.1, SW3.1 (A), U12.1 (VBAT), U12.19 (VDD), U12.32 (VDD), U12.48 (VDD), U12.64 (VDD); also elsewhere on the board
FCU_BOOT0: R25.1, U12.60 (BOOT0)
FCU_GPIO_A: U12.11 (PC3); also elsewhere on the board
FCU_GPIO_B: U12.10 (PC2); also elsewhere on the board
FCU_GPIO_C: U12.9 (PC1); also elsewhere on the board
FCU_GPIO_D: U12.8 (PC0); also elsewhere on the board
FCU_GPIO_E: U12.4 (PC15); also elsewhere on the board
FCU_GPIO_F: U12.3 (PC14); also elsewhere on the board
FCU_I2C1_SCL: R29.2, TP4.1, U12.61 (PB8); also elsewhere on the board
FCU_I2C1_SDA: R30.2, TP3.1, U12.62 (PB9); also elsewhere on the board
FCU_I2C2_SCL: R31.2, U12.29 (PB10); also elsewhere on the board
FCU_I2C2_SDA: R32.2, U12.30 (PB11); also elsewhere on the board
FCU_LED1: D11.2 (A), U12.36 (PB15)
FCU_LED2: D10.2 (A), U12.35 (PB14)
FCU_LED3: D9.2 (A), U12.34 (PB13)
FCU_LED4: D8.2 (A), U12.33 (PB12)
FCU_NRST: C53.1, SW4.2, SW4.4, U12.7 (NRST); also elsewhere on the board
FCU_OSC_IN: C43.1, U12.5 (PH0), Y2.1
FCU_OSC_OUT: R24.2, U12.6 (PH1)
FCU_SDIO_CLK: U12.53 (PC12); also elsewhere on the board
FCU_SDIO_CMD: U12.54 (PD2); also elsewhere on the board
FCU_SDIO_D0: U12.39 (PC8); also elsewhere on the board
FCU_SDIO_DET: U12.40 (PC9); also elsewhere on the board
FCU_SPI1_FLASH_CS: U12.20 (PA4); also elsewhere on the board
FCU_SPI1_MISO: U12.22 (PA6); also elsewhere on the board
FCU_SPI1_MOSI: U12.23 (PA7); also elsewhere on the board
FCU_SPI1_SCK: U12.21 (PA5); also elsewhere on the board
FCU_SWCLK: U12.49 (PA14); also elsewhere on the board
FCU_SWDIO: U12.46 (PA13); also elsewhere on the board
FCU_TIM2_CH1: U12.50 (PA15); also elsewhere on the board
FCU_TIM2_CH2: U12.55 (PB3); also elsewhere on the board
FCU_TIM3_CH1: U12.37 (PC6); also elsewhere on the board
FCU_TIM3_CH2: U12.38 (PC7); also elsewhere on the board
FCU_TIM3_CH3: U12.26 (PB0); also elsewhere on the board
FCU_TIM3_CH4: U12.27 (PB1); also elsewhere on the board
FCU_UART1_RX: U12.59 (PB7); also elsewhere on the board
FCU_UART1_TX: U12.58 (PB6); also elsewhere on the board
FCU_UART2_RX: U12.17 (PA3); also elsewhere on the board
FCU_UART2_TX: U12.16 (PA2); also elsewhere on the board
FCU_UART3_RX: U12.52 (PC11); also elsewhere on the board
FCU_UART3_TX: U12.51 (PC10); also elsewhere on the board
FCU_UART4_RX: U12.15 (PA1); also elsewhere on the board
FCU_UART4_TX: U12.14 (PA0); also elsewhere on the board
FCU_USB_OTG_FS_D+: U12.45 (PA12); also elsewhere on the board
FCU_USB_OTG_FS_D-: U12.44 (PA11); also elsewhere on the board
FCU_USB_OTG_FS_ID: U12.43 (PA10); also elsewhere on the board
FCU_USB_OTG_FS_VBUS: U12.42 (PA9); also elsewhere on the board
FCU_VDDA: C52.1, C54.1, FB2.2, U12.13 (VDDA)
GND: C40.2, C41.2, C42.2, C43.2, C44.2, C45.2, C46.2, C47.2, C48.2, C49.2, C50.2, C51.2, C52.2, C53.2, C54.2, R23.2, R26.2, R27.2, R28.2, SW3.3 (C), SW4.1, SW4.3, U12.12 (VSSA), U12.18 (VSS), U12.63 (VSS), Y2.2, Y2.4; also elsewhere on the board
unnamed: C46.1, R24.1, Y2.3
unnamed: D8.1 (K), R23.1
unnamed: D9.1 (K), R26.1
unnamed: D10.1 (K), R27.1
unnamed: D11.1 (K), R28.1
unnamed: R25.2, SW3.2 (B)
unnamed: C40.1, U12.31 (VCAP_1)
unnamed: C41.1, U12.47 (VCAP_2)

Notes on the sheet:
Reset Push Button
VDDA Filter
Decoupling Capacitors
I2C Pull-ups
Flight Control Unit
AN4488 - Getting started with STM32F4xxxx MCU hardware development AN2606 - Introduction to system memory boot mode on STM32 MCUs AN2867 - Guidelines for oscillator design on STM8AF/AL/S and STM32 MCUs/MPUs
Indicator LEDs
Boot Mode Selector
High Speed External Crystal (HSE)
I2C1 Test Point
