brenulevi/airplane/(commit log)

2026-01-14 power supply and navigation unit
    [aircraft.kicad_sch, navigation_unit.kicad_sch, power_supply.kicad_sch]
2026-01-17 fixed some errors in global labels
    [flight_control_peripherals.kicad_sch, flight_control_unit.kicad_sch, navigation_peripherals.kicad_sch, other_connections.kicad_sch]
2026-01-17 updated schematic pdf
2026-01-23 hardware version 0.1.2, minor improvements and footprint selection (missing some gnss and bulk regulator components
    [B10B-PHDSS.STEP, U.FL-R-SMT-1.stp, W25N01GVZEIG TR.STEP, aircraft.kicad_pcb, aircraft.kicad_sch, flight_control_peripherals.kicad_sch, flight_control_unit.kicad_sch, navigation_peripherals.kicad_sch]
2026-01-26 board placement, no trails, just pain
    [DM3AT-SF-PEJM5.step, IND_PA4343_FOOTPRINT2_PUL.step, PTS815SJM250SMTRLFS.stp, W25N01GVZEIG.STEP, aircraft.kicad_pcb, flight_control_peripherals.kicad_sch, flight_control_unit.kicad_sch, navigation_peripherals.kicad_sch]
2026-01-27 hardware: better layout, no power supply and sensors
    [aircraft.kicad_pcb, flight_control_unit.kicad_sch, other_connections.kicad_sch]
2026-01-28 fill zones done, layout reformulation because of 5v, power supply power traces done
    [aircraft.kicad_pcb, flight_control_peripherals.kicad_sch]
